pmezydlo/BeagleBone_serial_cape/README.md

<h1>Beagle Bone serial cape</h1>

<h2>License</h2>

<h2>Images</h2>
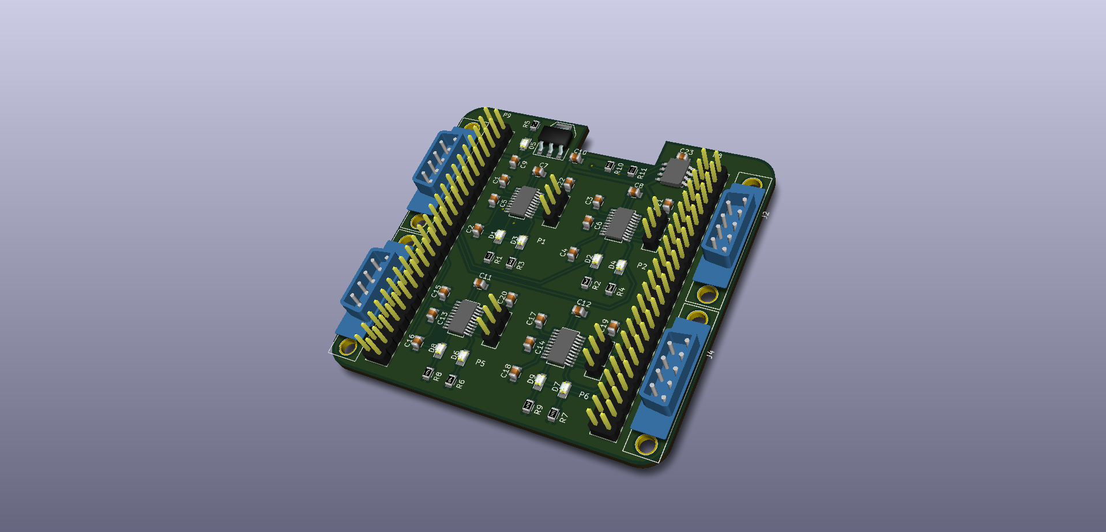
[picture p1: 3d_view.png]
