pmezydlo/BeagleBone_serial_cape/images/top_view.png

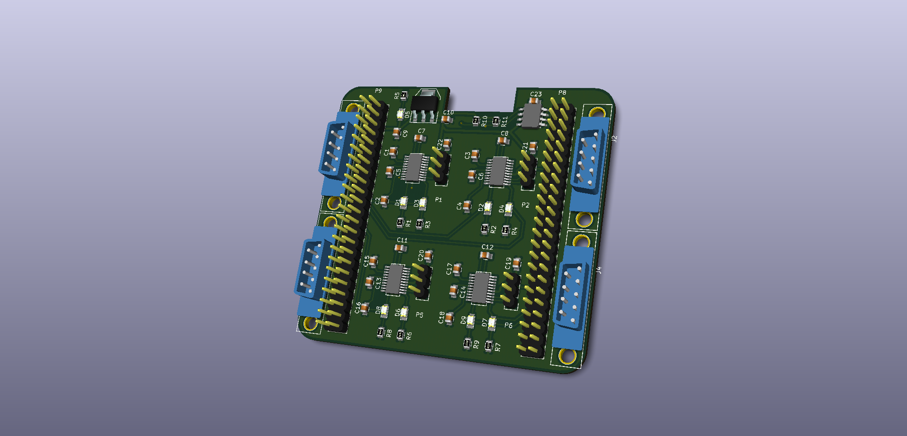
images/top_view.png
