pmezydlo/BeagleBone_serial_cape/BeagleBone_serial_cape.kicad_pcb

## KiCad design BeagleBone_serial_cape.kicad_pcb (2017-02-22)

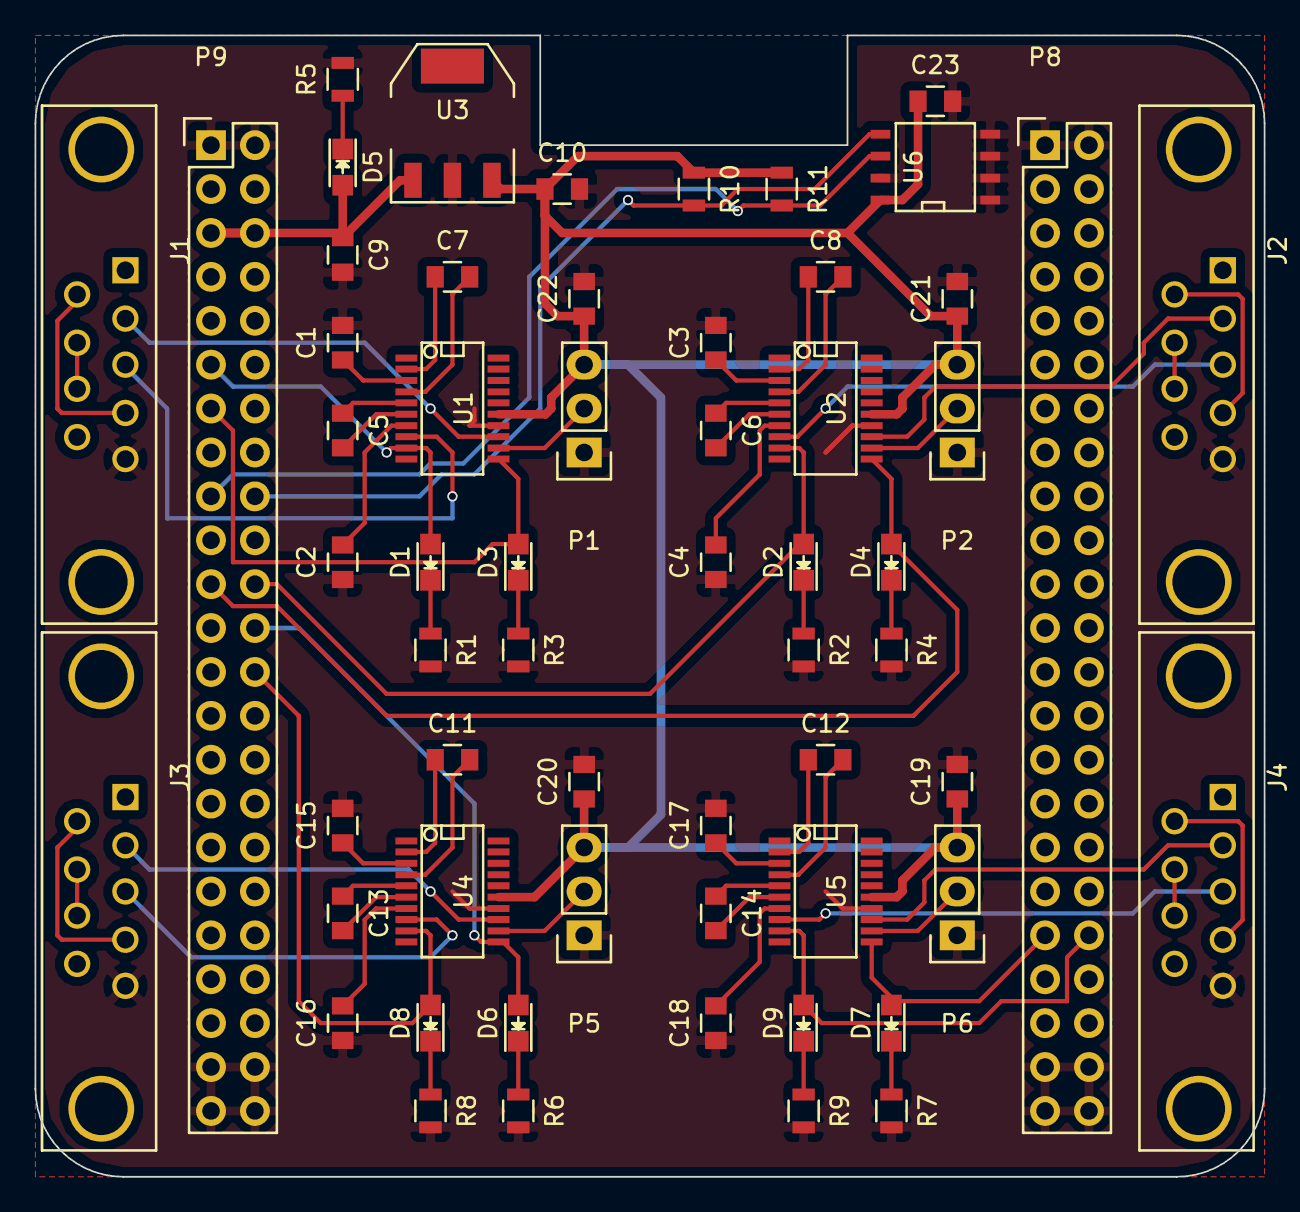
[picture p3: board BeagleBone_serial_cape.kicad_pcb from above]

Board: 2 copper layers, 71.1 x 66.0 mm, 59 parts (0 on the bottom side), 66 nets.

Parts:
C1, C2, C3, C4, C5, C6, C7, C8, C11, C12, C13, C14, C15, C16, C17, C18: 100n; C_0805
C9: 10u; C_0805
C10: 3.3u; C_0805
C19, C20, C21, C22, C23: 0.1u; C_0805
D1, D2, D3, D4, D6, D7, D8, D9: LED; LED_0805
D5: PWR; LED_0805
J1, J2, J3, J4: DB9; DB9MD
P1, P2, P5, P6: CONN_01X03; Pin_Header_Straight_1x03
P8, P9: CONN_02X23; Pin_Header_Straight_2x23
R1, R2, R3, R4, R5, R6, R7, R8, R9: 1k; R_0805
R10, R11: 10k; R_0805
U1, U2, U4, U5: MAX3227; SSOP-20
U3: LT1129MPST-3.3; SOT-223
U6: 24C512; SOIC-8-N

Connections:
+3V3: C10.1, C19.1, C20.1, C21.1, C22.1, C23.1, P1.3, P2.3, P5.3, P6.3, R10.1, R11.1, U1.15, U2.15, U3.3, U4.15, U5.15, U6.8
GND: C1.2, C2.1, C3.2, C4.1, C9.2, C10.2, C15.2, C16.1, C17.2, C18.1, C19.2, C20.2, C21.2, C22.2, C23.2, J1.5, J2.5, J3.5, J4.5, P1.1, P2.1, P5.1, P6.1, P8.1, P8.2, P8.43, P8.44, P8.45, P8.46, P9.1, P9.2, P9.43, P9.44, P9.45, P9.46, R1.2, R2.2, R3.2, R4.2, R5.2, R6.2, R7.2, R8.2, R9.2, U1.14, U2.14, U3.2, U4.14, U5.14, U6.1, U6.2, U6.3, U6.4, U6.7
unnamed: C1.1, U1.3
unnamed: C2.2, U1.7
unnamed: C3.1, U2.3
unnamed: C4.2, U2.7
unnamed: C5.1, U1.5
unnamed: C5.2, U1.6
unnamed: C6.1, U2.5
unnamed: C6.2, U2.6
unnamed: C7.1, U1.2
unnamed: C7.2, U1.4
unnamed: C8.1, U2.2
unnamed: C8.2, U2.4
unnamed: C11.1, U4.2
unnamed: C11.2, U4.4
unnamed: C12.1, U5.2
unnamed: C12.2, U5.4
unnamed: C13.1, U4.5
unnamed: C13.2, U4.6
unnamed: C14.1, U5.5
unnamed: C14.2, U5.6
unnamed: C15.1, U4.3
unnamed: C16.2, U4.7
unnamed: C17.1, U5.3
unnamed: C18.2, U5.7
unnamed: D1.1, R1.1
unnamed: D1.2, P9.11, U1.9
unnamed: D2.1, R2.1
unnamed: D2.2, P9.22, U2.9
unnamed: D3.1, R3.1
unnamed: D3.2, P9.13, U1.11
unnamed: D4.1, R4.1
unnamed: D4.2, P9.21, U2.11
unnamed: D5.1, R5.1
unnamed: D6.1, R6.1
unnamed: D6.2, P9.24, U4.11
unnamed: D7.1, R7.1
unnamed: D7.2, P8.37, U5.11
unnamed: D8.1, R8.1
unnamed: D8.2, P9.26, U4.9
unnamed: D9.1, R9.1
unnamed: D9.2, P8.38, U5.9
unnamed: J1.2, U1.13
unnamed: J1.3, U1.8
unnamed: J1.4, J1.6
unnamed: J1.7, J1.8
unnamed: J2.2, U2.13
unnamed: J2.3, U2.8
unnamed: J2.4, J2.6
unnamed: J2.7, J2.8
unnamed: J3.2, U4.13
unnamed: J3.3, U4.8
unnamed: J3.4, J3.6
unnamed: J3.7, J3.8
unnamed: J4.2, U5.13
unnamed: J4.3, U5.8
unnamed: J4.4, J4.6
unnamed: J4.7, J4.8
unnamed: P1.2, U1.12
unnamed: P2.2, U2.12
unnamed: P5.2, U4.12
unnamed: P6.2, U5.12
unnamed: P9.17, R11.2, U6.6
unnamed: P9.18, R10.2, U6.5
VCC: C9.1, D5.2, P9.5, P9.6, U3.1
