pmezydlo/BeagleBone_serial_cape/(threads)

Thread 1 (2017-02-22):

U1 pin 14 not connected to GND

mwelling, 2017-02-22:
The pour on the top layer does not reach U1 pin 14.

pmezydlo, 2017-02-22:
I corrected, I did not notice the lack of filled zone

Closed 2017-02-22.

Thread 2 (2017-02-22):

U2 pin 15 not connected to 3.3V

mwelling, 2017-02-22:
The 3.3V power rail does not reach U2 pin 15.

pmezydlo, 2017-02-22:
I corrected, I did not notice the lack of trace

Closed 2017-02-22.

Thread 3 (2017-02-22):

Power routing

mwelling, 2017-02-22:
Thicker traces or pours recommend for VCC and +3V3.

pmezydlo, 2017-02-22:
Yes you are right, 0,5mm tracks is it sufficient?

mwelling, 2017-02-22:
Yes that would be better.

Closed 2017-02-22.

Thread 4 (2017-02-22):

Cape EEPROM

mwelling, 2017-02-22:
It is recommend that the capes have a EEPROM (24c256) for auto-detection.

pmezydlo, 2017-02-22:
I corrected, EEPROM is on a cape

mwelling, 2017-02-22:
Good. You need to make sure the EEPROM also has a .1uF bypass capacitor.

pmezydlo, 2017-02-22:
I added it, Thanks for review Michael

Closed 2017-02-22.

Thread 5 (2017-02-22):

Bypass capacitors missing on U1-U4 pin 15

mwelling, 2017-02-22:
.1uF capacitors recommended on MAX3227 pin 15.

pmezydlo, 2017-02-22:
I corrected, I added 4 capacitor near U1-U4

Closed 2017-02-22.
