pmezydlo/BeagleBone_serial_cape/(commit log)

2017-02-21 initial commit 1.electrical schematic 2.arragement of elements
    [BeagleBone_serial_cape.kicad_pcb, BeagleBone_serial_cape.sch]
2017-02-21 routing pcb add more photos Signed-off-by: Patryk Mezydlo <mezydlo.p@gmail.com>
    [BeagleBone_serial_cape.kicad_pcb]
2017-02-22 add EEPROM for auto-detect add thicker traces fixed GND and 3.3v routing add bypass capacitors
    [BeagleBone_serial_cape.kicad_pcb, BeagleBone_serial_cape.sch]
2017-02-22 add bypass capacitor for EEPROM memory
    [BeagleBone_serial_cape.kicad_pcb, BeagleBone_serial_cape.sch]
